justinrosner/next-step/README.md

# next-step
Final year software engineering capstone project. This project uses an Arduino in combination with ultrasonic sensors and a Lidar to provide guidance for visually impaired users in indoor settings.

## Directory Overview
    .
    ├── documentation           # Documentation files 
    ├── main                    # Source Arduino files
    ├── sound-files             # Contains all .wav files
    ├── .gitignore
    └── README.md

## Contributing
Before you push any changes to your local branch for review, make sure that you are following the correct C++ style guidelines.

For the purposes of this project we are using `clang-format` with the `-style=Google` option.

Full command:
```
clang-format -i -style=Google <YOUR FILE HERE>
```
