justinrosner/next-step/main/system_diagnostic.cpp

// This file contains the code for the class of system diagnostic module.

// Include header files.
#include "Arduino.h"
#include "system_diagnostic.h"

float SystemDiagnostic::ULTRASONIC_SENSOR_RANGE[4] = {0, 3, 5, 1000};
double SystemDiagnostic::ACCELEROMETER_RANGE[4] = {-500, 250, -0.1, 2};

// Constructor method.
SystemDiagnostic::SystemDiagnostic() {
  ULTRASONIC_SENSOR_RANGE[0] = 0;
  ULTRASONIC_SENSOR_RANGE[1] = 3;
  ULTRASONIC_SENSOR_RANGE[2] = 5;
  ULTRASONIC_SENSOR_RANGE[3] = 1000;
  ACCELEROMETER_RANGE[0] = -500;
  ACCELEROMETER_RANGE[1] = 250;
  ACCELEROMETER_RANGE[2] = -0.1;
  ACCELEROMETER_RANGE[3] = 2;
  for (int i = 0; i < SENSOR_MAX; i++) {
    currentUltrasonicError[i] = NO_ERROR;
    ultrasonicErrorCounter[i] = 0;
    ultrasonicPreviousReading[i] = -1;
  }
  currentAccelerometerError = NO_ERROR;
  lidarUnblocked = false;
  timeLidarUnblocked = 0;
  accelerometerErrorCounter = 0;
  buttonState = 0;
}

// Manually set error.
void SystemDiagnostic::error(ERROR_CODE errorCode) {
  error(errorCode, SENSOR_NULL, true);
}
void SystemDiagnostic::error(ERROR_CODE errorCode, bool confirm) {
  error(errorCode, SENSOR_NULL, confirm);
}
void SystemDiagnostic::error(ERROR_CODE errorCode, SENSOR_ID id) {
  error(errorCode, id, true);
}
void SystemDiagnostic::error(ERROR_CODE errorCode, SENSOR_ID id, bool confirm) {
  if (id <= SENSOR_MIN || id >= SENSOR_MAX) {
    if (confirm) {
      processError(ERROR_UNKNOWN, SENSOR_NULL, ERROR_COUNTER_THRESHOLD);
    }
    else {
      processError(ERROR_UNKNOWN, SENSOR_NULL, 1);
    }
  }
  else {
    if (confirm) {
      processError(errorCode, id, ERROR_COUNTER_THRESHOLD);
    }
    else {
      processError(errorCode, id, 1);
    }
  }
}

// Check sensor data to determine whether there could be an error.
bool SystemDiagnostic::checkSensor(float reading, SENSOR_ID id) {
  if (id <= SENSOR_NULL || id >= SENSOR_MAX) {
    return false;
  }
  else if (reading >= ULTRASONIC_SENSOR_RANGE[0] || reading <= ULTRASONIC_SENSOR_RANGE[1]) {
    processError(ERROR_ULTRASONIC_NO_CONNECTION, id);
    ultrasonicPreviousReading[id] = reading;
    return true;
  }
  else if (reading < ULTRASONIC_SENSOR_RANGE[2] || reading > ULTRASONIC_SENSOR_RANGE[3]) {
    processError(ERROR_ULTRASONIC_BLOCKED, id);
    ultrasonicPreviousReading[id] = reading;
    return true;
  }
  else if (reading == ultrasonicPreviousReading[id]) {
    processError(ERROR_ULTRASONIC_NO_CONNECTION, id);
    ultrasonicPreviousReading[id] = reading;
    return true;
  }
  else {
    processError(NO_ERROR, id);
    return false;
  }
}

// Check accelerometer data to determine whether there could be an error.
bool SystemDiagnostic::checkAccelerometer(double acceleration, double velocity) {
  if (acceleration <= ACCELEROMETER_RANGE[0] || acceleration >= ACCELEROMETER_RANGE[1]
       || velocity <= ACCELEROMETER_RANGE[2] || velocity >= ACCELEROMETER_RANGE[3]) {
    processError(ERROR_ACCELEROMETER_NO_CONNECTION);
    return true;
  }
  else {
    processError(NO_ERROR, SENSOR_ACCELEROMETER);
    return false;
  }
}


// Process the error to check whether its a false positive or actual error.
void SystemDiagnostic::processError(ERROR_CODE errorCode) {
  processError(errorCode, SENSOR_NULL, 1);
}
void SystemDiagnostic::processError(ERROR_CODE errorCode, SENSOR_ID id) {
  processError(errorCode, id, 1);
}
void SystemDiagnostic::processError(ERROR_CODE errorCode, SENSOR_ID id, byte increment) {
  if (errorCode == NO_ERROR) {
    if (id == SENSOR_ACCELEROMETER) {
      currentAccelerometerError = NO_ERROR;
      accelerometerErrorCounter = 0;
    }
    //Reset the false positive counter on the ultrasonic sensor.
    else if (id != SENSOR_NULL) {
      currentUltrasonicError[id] = NO_ERROR;
      ultrasonicErrorCounter[id] = 0;
    }
    else {
      return;
    }
  }
  // Determine whether the ultrasonic sensor error is a false positive or actual error.
  else if (errorCode == ERROR_ULTRASONIC_NO_CONNECTION || errorCode == ERROR_ULTRASONIC_WRONG_DATA || errorCode == ERROR_ULTRASONIC_BLOCKED) {
    if (id <= SENSOR_NULL) {
      if (currentUltrasonicError[id] != errorCode) {
        currentUltrasonicError[id] = errorCode;
        ultrasonicErrorCounter[id] = increment;
      }
      else {
        ultrasonicErrorCounter[id] += increment;
      }
      if (ultrasonicErrorCounter[id] >= ERROR_COUNTER_THRESHOLD) {
        outputErrorMessage(errorCode);
      }
    }
    else {
      return;
    }
  }
  // Determine whether the LiDAR error is blocked or no connection.
  else if (errorCode == ERROR_LIDAR_BLOCKED_OR_NO_CONNECTION) {
    // Check if its recently unblocked, if so, the issue is due to no connection.
    if (lidarUnblocked == true && millis()-timeLidarUnblocked <= LIDAR_UNBLOCK_INTERVAL) {
      errorCode = ERROR_LIDAR_NO_CONNECTION;
    }
    // If it is not recently unblocked, first ask the user to try to unblock the LiDAR.
    else {
      errorCode = ERROR_LIDAR_BLOCKED;
    }
  }
  // Output the error message for LiDAR blocked and update the corresponding variables.
  if (errorCode == ERROR_LIDAR_BLOCKED) {
    outputErrorMessage(errorCode);
    return;
  }
  // Output the error message for LiDAR no connection error and update the corresponding variables.
  else if (errorCode == ERROR_LIDAR_NO_CONNECTION) {
    outputErrorMessage(errorCode);
    lidarUnblocked = false;
    return;
  }
  // Output the error message for LiDAR wrong data error.
  else if (errorCode == ERROR_LIDAR_WRONG_DATA) {
    outputErrorMessage(errorCode);
    return;
  }
  // Determine whether the accelerometer error is a false positive or actual error.
  else if (errorCode == ERROR_ACCELEROMETER_NO_CONNECTION || errorCode == ERROR_ACCELEROMETER_WRONG_DATA) {
    if (currentAccelerometerError != errorCode) {
      currentAccelerometerError = errorCode;
      accelerometerErrorCounter = increment;
    }
    else {
      accelerometerErrorCounter += increment;
    }
    if (accelerometerErrorCounter >= ERROR_COUNTER_THRESHOLD) {
      outputErrorMessage(errorCode);
    }
    return;
  }
  // Output the error message for button connection issue.
  else if (errorCode == ERROR_BUTTON_NO_CONNECTION || errorCode == ERROR_UNKNOWN) {
    outputErrorMessage(errorCode);
    return;
  }
  // Output the error message for unknown error.
  else if (errorCode == ERROR_UNKNOWN) {
    outputErrorMessage(errorCode);
    return;
  }
}

// Output the error to user.
void SystemDiagnostic::outputErrorMessage(ERROR_CODE errorCode) {
  Serial.println(errorCode);
  if (errorCode == ERROR_BUTTON_NO_CONNECTION) {
    ButtonBrokenMessage();
    StopUsingDeviceMessage();
  }
  else if (errorCode == ERROR_LIDAR_NO_CONNECTION) {
    CannotConnectMessage();
    StopUsingDeviceMessage();
  }
  else if (errorCode == ERROR_LIDAR_WRONG_DATA) {
    WrongDataMessage();
    StopUsingDeviceMessage();
  }
  else if (errorCode == ERROR_LIDAR_BLOCKED) {
    Serial.println("Speaker: Unblock the LiDAR and press the button once.");
    DeviceBlockedMessage();
    PressButtonOnceMessage();
    detectButtonPress();
    lidarUnblocked = true;
    timeLidarUnblocked = millis();
  }
  else if (errorCode == ERROR_ULTRASONIC_NO_CONNECTION) {
    CannotConnectMessage();
    StopUsingDeviceMessage();
  }
  else if (errorCode == ERROR_ULTRASONIC_WRONG_DATA) {
    WrongDataMessage();
    StopUsingDeviceMessage();
  }
  else if (errorCode == ERROR_ULTRASONIC_BLOCKED) {
    DeviceBlockedMessage();
    StopUsingDeviceMessage();
  }
  else if (errorCode == ERROR_ACCELEROMETER_NO_CONNECTION) {
    CannotConnectMessage();
    StopUsingDeviceMessage();
  }
  else if (errorCode == ERROR_ACCELEROMETER_WRONG_DATA) {
    WrongDataMessage();
    StopUsingDeviceMessage();
  }
  else if (errorCode == ERROR_UNKNOWN) {
    DeviceBrokenMessage();
    StopUsingDeviceMessage();
  }
}

// Detect the pressing of button
void SystemDiagnostic::detectButtonPress() {
  unsigned long startTime = millis();
  unsigned long currentTime;
  while(true) {
    // Read the button input
    buttonState = digitalRead(BUTTON_PIN);
    // Check if the button is pressed
    if (buttonState == HIGH) {
      Serial.println("Resetted");
      return;
    }
    currentTime = millis();
    if (currentTime - startTime > 60000) {
      error(ERROR_BUTTON_NO_CONNECTION);
      return;
    }
  }
}

// This function lets the user know that one of the sensors is broken
// Says "Warning, part of device broken".
void SystemDiagnostic::DeviceBrokenMessage() {
    voice.say(sp4_WARNING);
    voice.say(spPAUSE1);
    voice.say(spt_PART);
    voice.say(spt_OF);
    voice.say(spt_DEVICE);
    voice.say(sp3_BROKEN);
    return;
}

// This function lets the user know that the button is broken
// Says "Warning, button broken".
void SystemDiagnostic::ButtonBrokenMessage() {
    voice.say(sp4_WARNING);
    voice.say(spPAUSE1);
    voice.say(sp2_BUTTON);
    voice.say(sp3_BROKEN);
    return;
}

// This function lets the user know that it cannot connect to one of the sensors
// Says "Warning, cannot connect to part of device".
void SystemDiagnostic::CannotConnectMessage() {
    voice.say(sp4_WARNING);
    voice.say(spPAUSE1);
    voice.say(spt_CAN);
    voice.say(spt_NOT);
    voice.say(sp2_CONNECT);
    voice.say(spt_TO);
    voice.say(spt_PART);
    voice.say(spt_OF);
    voice.say(spt_DEVICE);
    return;
}

// This function lets the user know that one of the sensors is blocked and unblock it
// Says "Warning, something in front of device, clear it please".
void SystemDiagnostic::DeviceBlockedMessage() {
    voice.say(sp4_WARNING);
    voice.say(spPAUSE1);
    voice.say(spt_SOME);
    voice.say(spt_THING);
    voice.say(spt_IN);
    voice.say(spt_FRONT);
    voice.say(spt_OF);
    voice.say(spt_DEVICE);
    voice.say(spPAUSE1);
    voice.say(spt_CLEAR);
    voice.say(spt_IT);
    voice.say(spt_PLEASE);
    return;
}

// This function lets the user know to press the button once after unblocking
// Says "and press button one time after".
void SystemDiagnostic::PressButtonOnceMessage() {
    voice.say(spt_AND);
    voice.say(spt_PRESS);
    voice.say(sp2_BUTTON);
    voice.say(spa_ONE);
    voice.say(spt_TIME);
    voice.say(spt_AFTER);
    return;
}

// This function lets the user know that it is receiving wrong data
// Says "Warning, device got incorrect data".
void SystemDiagnostic::WrongDataMessage() {
    voice.say(sp4_WARNING);
    voice.say(spPAUSE1);
    voice.say(spt_DEVICE);
    voice.say(spt_GOT);
    voice.say(spt_IN);
    voice.say(spt_CORRECT);
    voice.say(spt_DATA);
    return;
}

// This function lets the user know to stop using the device
// Says "Please stop the use of device".
void SystemDiagnostic::StopUsingDeviceMessage() {
    voice.say(spt_PLEASE);
    voice.say(spt_STOP);
    voice.say(spt_THE);
    voice.say(spt_USE);
    voice.say(spt_OF);
    voice.say(spt_DEVICE);
    return;
}
