justinrosner/next-step/main/guidance.ino

// This file contains all of the code pertaining to the guidance system. This
// uses sensor information from ultrasonic sensors, lidar, and accelerometer to
// determine where the user should move to avoid running into an object. The
// following code implements the "Bubble Rebound Algorithm"

// Header files to include for the guidance system
#include <math.h>

// Constants used in the "Bubble Rebound Algorithm"
double bubble_boundary[N];
const double ki = 5;  // This is a scaling constant. Try values between [0.2-3]
const double alpha_0 = M_PI / N;

// This function updates the bubble_boundary array
void UpdateBubbleBoundary() {
  // Update the velocity
  // TO-DO: Uncomment this when the accelerometer is setup in final system
  UpdateVelocity();
  velocity = abs(velocity);  // temp value for velocity (measure in cm/s)
  double value = 0.0;
  
  // If the velocity is less than 1m/s then we want to use a fixed bubble
  // boundary size
  if (velocity <= 100.0) {
    value = 100.0;
  }
  else if (velocity >= 500.0) {
    value = 500.0;
  } else if(isnan(velocity)){
    value=500;
  }
  else{
     value = velocity;

   }

  
  //Serial.println("Bubble Boundary: " + String(ki * value));

  for (int i = 0; i < N; i++) {
    // Update the bubble_boundary value
    bubble_boundary[i] = ki * value;
  }
}

// This function performs a basic check to see if there is an obstacle in the
// bubble
bool CheckForObstacles() {
  int count = 0;
  byte countTurnAround = 0;
  for (int i = 5; i > 0; i--) {
    if (fused_distances[1] <= 100.0 && fused_distances[2] <= 125 && \
        fused_distances[3] <= 150 && fused_distances[4] <= 125 && \
        fused_distances[5] <= 100) {
      countTurnAround++;
    }
  }
  
  if (countTurnAround == 5) {
    //call talkie turn around
    Serial.println("Turn around");
    TurnAroundMessage();
  }
  else {
    for (int i = 0; i < N; i++) {
    if (fused_distances[i] <= bubble_boundary[i])
      count++;
    }
  
    // If none of the sensors have detected an object we return false
    if (count == 0) {
      return false;
    }
  }
  
  // Otherwise it means that the sensors have detected an object and
  // we return true
  return true;
}

// This function computes the rebound angle. The rebound angle is the direction
// in which we will now be travelling to avoid running into the obstacle.
float ComputeReboundAngle() {
  double numerator = 0;
  double denominator = 0;

  // Loop to calculate the numerator and denominator
  for (int i = 0; i < N; i++) {
    double alpha_i = (i + 1) * alpha_0;
    //Serial.println(String(fused_distances[i])+ " " + String(i));
    numerator += alpha_i * fused_distances[i];
    denominator += fused_distances[i];
  }

  return numerator / denominator;
}

// This function calculates what sector to indicate (with the haptic motors)
// based off of the rebound angle. The first sector is the one which the right
// sensor covers and as the sectors increase they move across the sensors until
// you get to the last sector (the left ultrasonic sensor)
int CalculateSector(float rebound_angle) {
  //Serial.println("Rebound Angle = " + String(rebound_angle) + " ");
  // Falls in the first sector (where the left sensor is)
  if (rebound_angle >= 0 && rebound_angle < 0.62) {
    Serial.println("LEFT BUZZER");
    DriveLeftMotor();
  } else if (rebound_angle >= 0.62 && rebound_angle < 1.25) {
    // Falls in the second sector
    Serial.println("CENTER LEFT BUZZER");
    DriveCenterLeftMotor();
  } else if (rebound_angle >= 1.25 && rebound_angle < 1.88) {
    // Falls in the third sector
    Serial.println("CENTER BUZZER");
    DriveCenterMotor();
  } else if (rebound_angle >= 1.88 && rebound_angle < 2.51) {
    // Falls in the fourth sector
    Serial.println("CENTER RIGHT BUZZER");
    DriveCenterRightMotor();
  } else if (rebound_angle >= 2.51 && rebound_angle < 3.14) {
    // Falls in the fifth sector (Where the right sensor is)
    Serial.println("RIGHT BUZZER");
    DriveRightMotor();
  } else {
    // Otherwise there are no free moves that can be made and the user
    // should be instructed to turn around
  }
}

// Main function that implements the "Bubble Rebound Algorithm"
void MainGuidance() {
  // Gather the data from the sensor fusion algorithm
  MainSensorFusion();

  // Update the Bubble Boundary
  UpdateBubbleBoundary();

 
  // Check if there is an obstacle in the bubble
  if (CheckForObstacles()) {
    // Obstacle found, compute new heading
    float new_direction = ComputeReboundAngle();
    CalculateSector(new_direction);
  } else {
    // No obstacle found, keep moving straight (no guidance needed)
    return;
  }
  
}
