justinrosner/next-step/(commit log)

2022-01-04 Removing camera module from codebase
2022-01-06 Setup haptic motor file for dev work
2022-01-10 Setup for three ultrasonic sensors
2022-01-10 Setup complete for 5 ultrasonic sensors
2022-01-11 Added API to drive haptic motors
2022-01-11 Added drive functions for the 5 motors
2022-01-11 Data cleaning using moving point average filter
2022-01-11 Adding basic accelerometer functionality
2022-01-12 Basic object avoidance implemented
    [accelerometer.ino, guidance.ino, main.ino, sensor_fusion.ino]
2022-01-12 Baisc guidance code working with mega board
2022-01-13 accelerometer setup
2022-01-15 Fixing bugs in guidance system
    [guidance.ino]
2022-01-15 LiDAR code modified and added to loop
2022-01-15 formatted lidar.ini using clang-format
2022-01-27 Added print statement for presentation demo
2022-02-08 Updated accelerometer work
2022-03-12 Updated pins for ultrasonic sensors
2022-03-12 added Lidar pin change
2022-03-12 V1.1 for System Diagnostic Module
    Added button support for LiDAR debug.
2022-03-12 V1.1 of system diagnostic module
    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
2022-03-12 Add files via upload
    adding sensor fusion filtering and data pipeline classes
2022-03-12 Adding new files with updated units for distance
    files for fusion filtering and datapipeline
2022-03-12 Adding button press functionality to main
2022-03-12 Update sensor_fusion.ino
    change function name so no function clashes
2022-03-12 Update pin used for haptic motor
    Update pin used for haptic motor
2022-03-12 Use speaker instead of serial.print
2022-03-12 Bug fixes for SD card reader
    [SDReader.ino]
2022-03-12 ADDED pin setup
2022-03-12 Use pin mapping from system diagnostic module
    Use pin mapping from system diagnostic module instead of redefining it again.
2022-03-12 added intersection fusion
    added final filtering, fusion and datapipline to repo
2022-03-13 Remove duplicate pin setup
    Remove duplicate pin setup
2022-03-17 Added Diagnostic for Accelerometer
    Added diagnostic for accelerometer, including connection issue and accelerometer reporting wrong data.
    [system_diagnostic.cpp]
2022-03-22 Error check for button input
    [PushButton.ino, system_diagnostic.cpp]
2022-03-22 Update and optimize error checking logic
    [system_diagnostic.cpp, system_diagnostic.h]
2022-03-23 Reupload error checking code
    [PushButton.ino, system_diagnostic.cpp, system_diagnostic.h]
2022-03-29 added offset and filtering
    adding offest finding code in the setup and the filtering of acceleration in the getXAcceleration function call
2022-04-04 Fix system diagnostic memory issue
    [main.ino, sensorFusion.ino, system_diagnostic.cpp, system_diagnostic.h]
2022-04-28 turn around feature and accelerometer code
2022-07-31 Removing old sensor fusion files
